tristanluther28/psx_dreamcast_radio/README.md

# PlayStation & Dreamcast Radio Controller!
More to come: Pardon our dust

https://tristanluther.com/projects/psx_dream_radio/
