tristanluther28/psx_dreamcast_radio/Enclosure/Lid.3mf

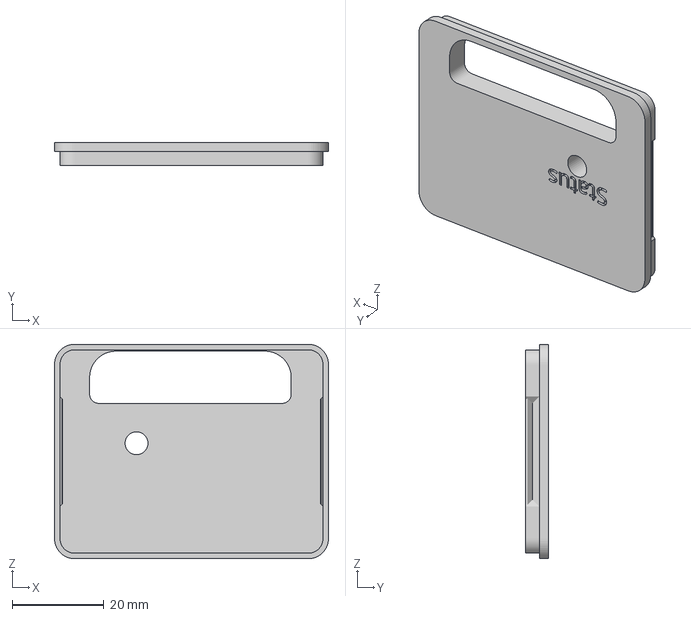
[picture p1: CAD file, 2021-08-06]
Enclosure/Lid.3mf
59.8 x 5.00 x 46.8 mm
