tristanluther28/psx_dreamcast_radio/Enclosure/Lower_Enclosure_PSX.3mf

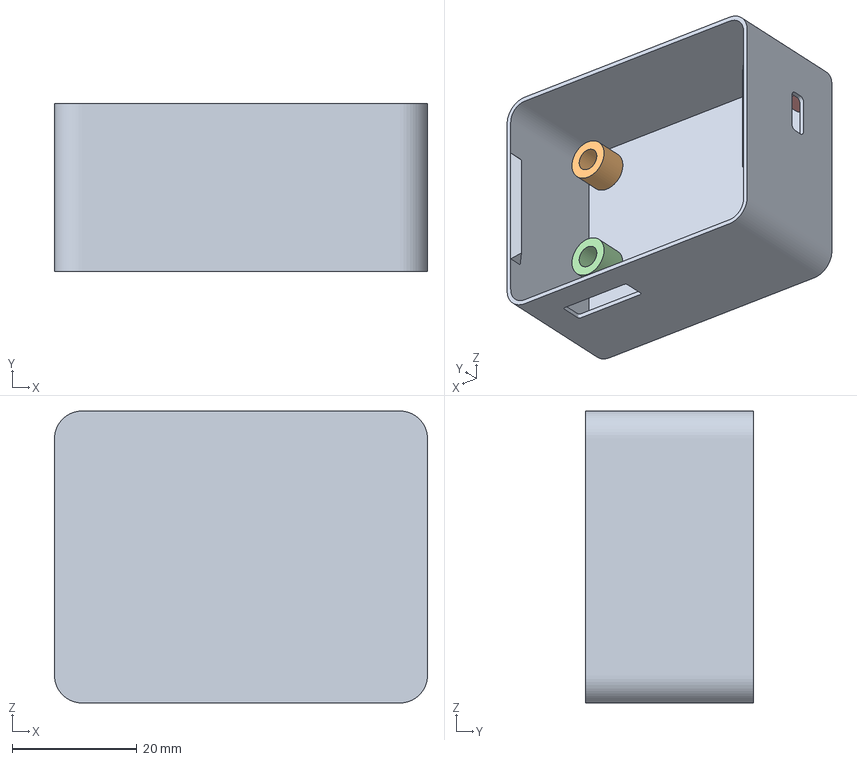
[picture p2: CAD file, 2021-08-06]
Enclosure/Lower_Enclosure_PSX.3mf
59.8 x 27.0 x 46.8 mm
