tristanluther28/psx_dreamcast_radio/(list of files, cad)

Other CAD files:
Enclosure/Lower_Enclosure_Dreamcast.3mf
