tristanluther28/psx_dreamcast_radio/PCB/PSX_Radio.brd

## EAGLE design PCB/PSX_Radio.brd (2021-08-06)

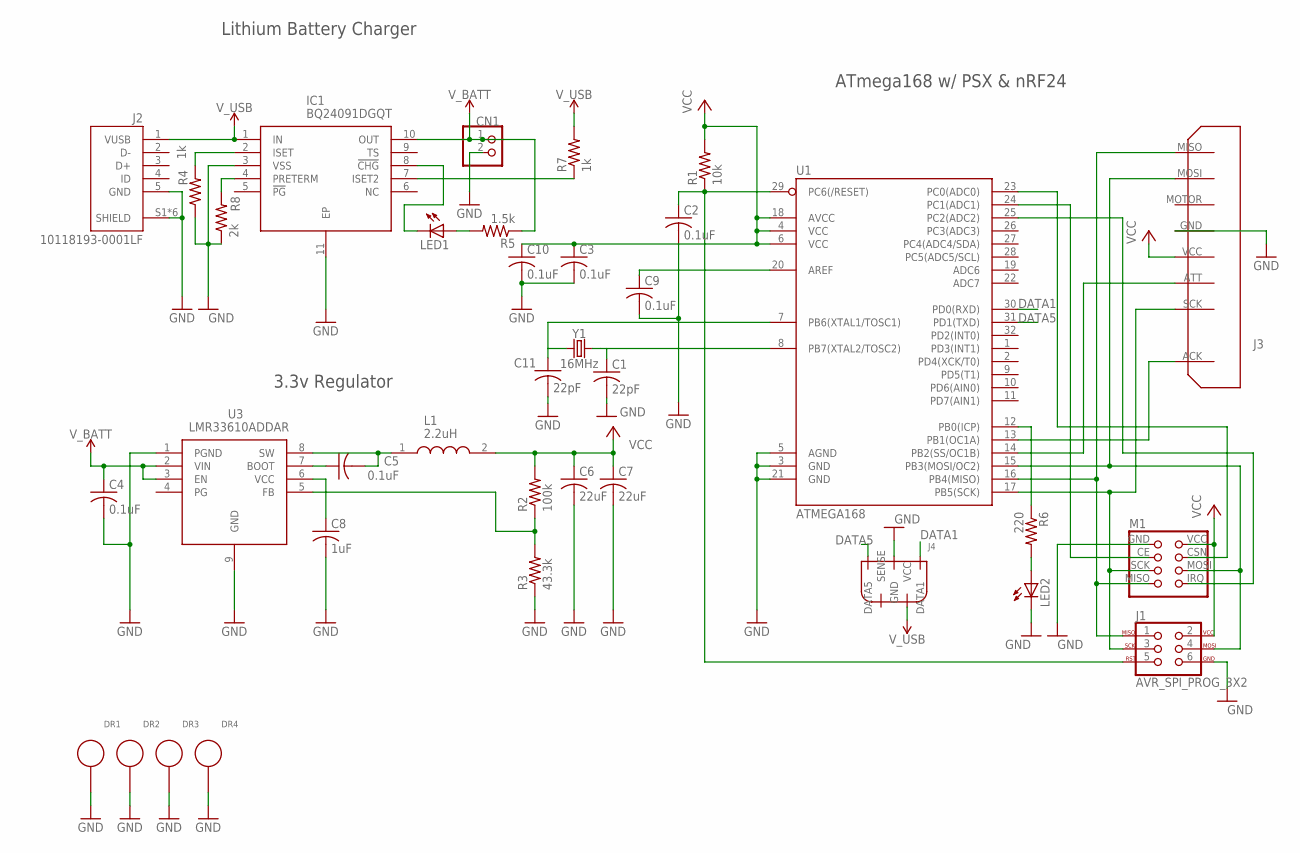
[picture p3: schematic PSX_Radio.sch]

Parts:
C1, C11: 22pF; C0805
C2, C3, C4, C5, C9, C10: 0.1uF; C0805
C6, C7: 22uF; C0805
C8: 1uF; C0805
CN1: JST_2PIN-SMT-RA; JST-PH-2-SMT-RA
DR1, DR2, DR3, DR4: 3MM_DRILL_GND
IC1: BQ24091DGQT; SOP50P490X110-11N
J1: AVR_SPI_PROG_3X2; 2X3-NS
J2: 10118193-0001LF; FCI_10118193-0001LF
J3: PSX_CONTROLLER; PSX_VERTICAL
J4: DREAMCAST_CONTROLLER; 1X06
L1: 2.2uH; INDPM5752X150N
LED1, LED2: LED5MM
M1: NRF24L01_MODULE; 2X04
R1: 10k; R0805
R2: 100k; R0805
R3: 43.3k; R0805
R4, R7: 1k; R0805
R5: 1.5k; R0805
R6: 220; R0805
R8: 2k; R0805
U1: ATMEGA168; TQFP32-08
U3: LMR33610ADDAR; SOIC127P600X170-9N
Y1: 16MHz; CRYSTAL-SMD-5X3.2-4PAD

Connections:
DATA1: J4.2 (DATA1), U1.30 (PD0(RXD))
DATA5: J4.4 (DATA5), U1.31 (PD1(TXD))
GND: C1.2, C2.2, C3.2, C4.2, C6.2, C7.2, C8.2, C9.2, C10.2, C11.2, CN1.2 (1), DR1.DR, DR2.DR, DR3.DR, DR4.DR, IC1.3 (VSS), IC1.11 (EP), J1.6, J2.5 (GND), J2.S1 (SHIELD), J2.S2 (SHIELD), J2.S3 (SHIELD), J2.S4 (SHIELD), J2.S5 (SHIELD), J2.S6 (SHIELD), J3.GND, J4.5 (GND), LED2.K (C), M1.GND, R3.1, R4.1, R8.1, U1.3 (GND), U1.5 (AGND), U1.21 (GND), U3.1 (PGND), U3.9 (GND)
unnamed: J1.1, J3.MISO, M1.MISO, U1.16 (PB4(MISO))
unnamed: J1.4, J3.MOSI, M1.MOSI, U1.15 (PB3(MOSI/OC2))
unnamed: J3.ACK, U1.13 (PB1(OC1A))
unnamed: M1.IRQ, U1.25 (PC2(ADC2))
unnamed: J1.3, J3.SCK, M1.SCK, U1.17 (PB5(SCK))
unnamed: M1.CE, U1.24 (PC1(ADC1))
unnamed: J3.ATT, U1.14 (PB2(SS/OC1B))
unnamed: M1.CSN, U1.23 (PC0(ADC0))
unnamed: C2.1, J1.5, R1.1, U1.29 (PC6(/RESET))
unnamed: C9.1, U1.20 (AREF)
unnamed: C5.1, U3.7 (BOOT)
unnamed: C5.2, L1.1, U3.8 (SW)
unnamed: IC1.2 (ISET), R4.2
unnamed: R2.1, R3.2, U3.5 (FB)
unnamed: C8.1, U3.6 (VCC)
unnamed: R6.1, U1.12 (PB0(ICP))
unnamed: LED2.A, R6.2
unnamed: C1.1, U1.8 (PB7(XTAL2/TOSC2)), Y1.3 (2)
unnamed: C11.1, U1.7 (PB6(XTAL1/TOSC1)), Y1.1
unnamed: LED1.A, R5.2
unnamed: IC1.8 (!CHG), LED1.K (C)
unnamed: IC1.7 (ISET2), R7.1
unnamed: IC1.4 (PRETERM), R8.2
VCC: C3.1, C6.1, C7.1, C10.1, J1.2, J3.VCC, L1.2, M1.VCC, R1.2, R2.2, U1.4 (VCC), U1.6 (VCC), U1.18 (AVCC)
V_BATT: C4.1, CN1.1 (2), IC1.10 (OUT), R5.1, U3.2 (VIN), U3.3 (EN)
V_USB: IC1.1 (IN), J2.1 (VUSB), J4.1 (VCC), R7.2

Notes on the sheet:
Lithium Battery Charger
3.3v Regulator
ATmega168 w/ PSX & nRF24

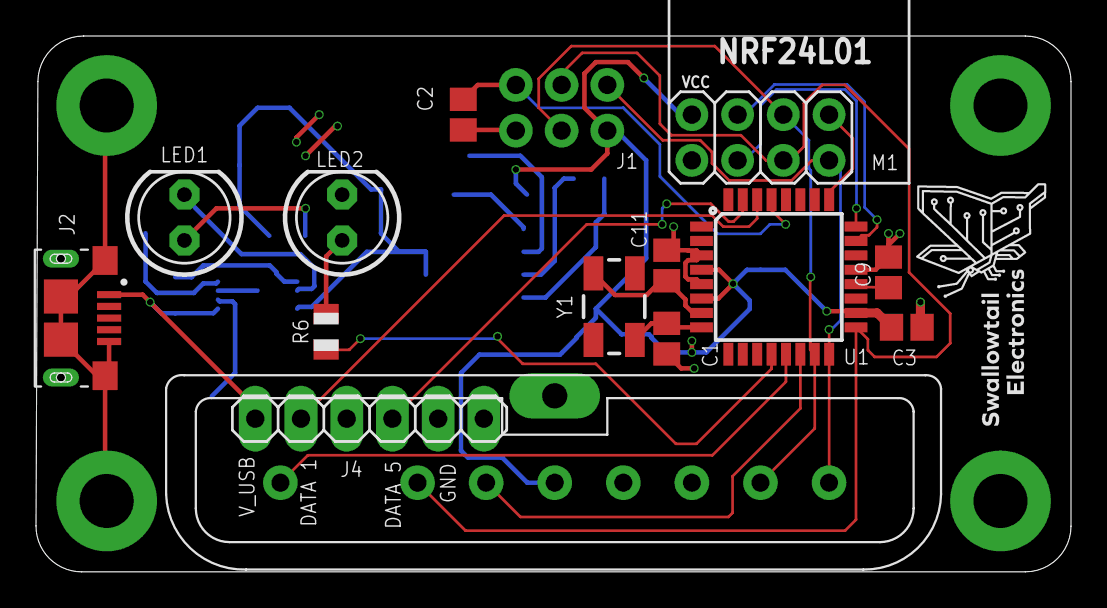
[picture p4: board PSX_Radio.brd from above]

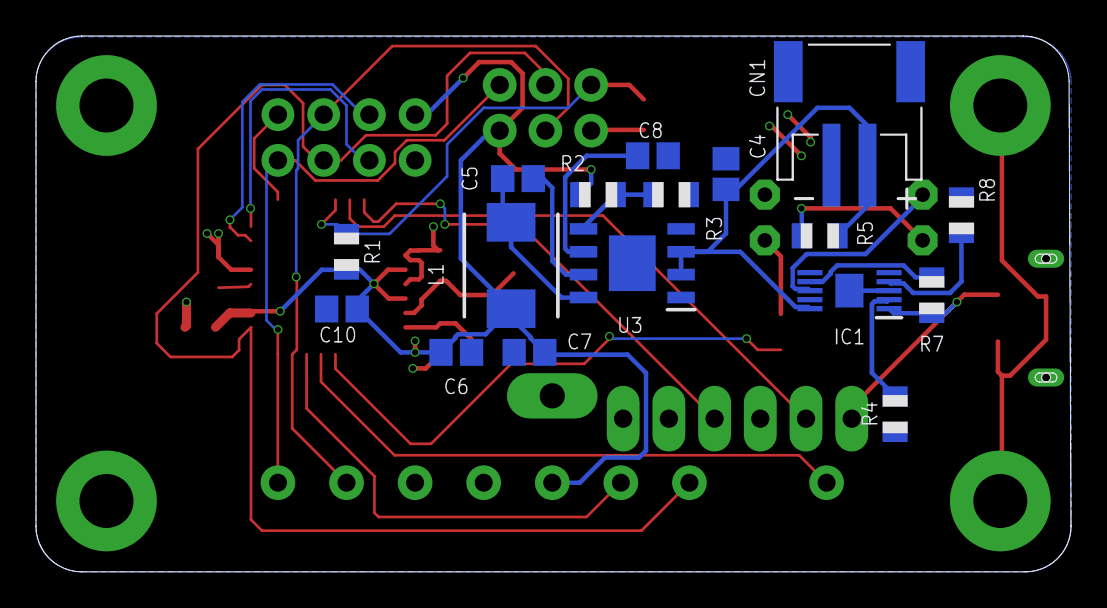
[picture p5: board PSX_Radio.brd from below]

Board: 2 copper layers, 57.5 x 29.8 mm, 37 parts (17 on the bottom side), 29 nets.

Other parts of the board:
U$3: SWALLOWTAIL_LOGO_SMALL
