tristanluther28/psx_dreamcast_radio/Dreamcast2.4GHz/AnimatorDreamcast2.4GHz/main.c

//-----------------------------------------------------------------------------
//
//  main.c
//
//  Swallowtail Animator Controller 2.4GHz Firmware
//  AVR (ATmega328P) Animator Controller 2.4GHz Firmware
//
//  Copyright (c) 2021 Swallowtail Electronics
//
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
//  Web:    http://tristanluther.com
//  Email:  tristanluther28@gmail.com
//
//-----------------------------------------------------------------------------

/******************** Macros *****************************/
#ifndef F_CPU
#define F_CPU 16000000UL //Set clock speed to 16MHz (External 16MHz @ 3.3V is overclocking the AVR according to the datasheet, should be fine)
#endif

#define BIT_SET(byte, bit) (byte & (1<<bit))

/******************** Includes ***************************/
#include <avr/io.h>
#include <avr/interrupt.h>
#include <avr/pgmspace.h>
#include <util/delay.h>

/******************* Globals *****************************/

//Must use the static keyword or the compiler will welcome itself to overwrite these memory locations in SRAM
//Must use volatile keyword or the compiler will optimize out any variables that are not seen in main (only appear in ISR)


/******************* Local Includes **********************/
#include "Dreamcast.h"
#include "nRF24L01.h"

/******************** Functions **************************/


/********** Interrupt Service Routines *******************/


/******************** Main *******************************/
int main(void)
{
	//nRF RX Address (5 bytes wide)
	static uint8_t rx_address[5] = {0x12, 0x12, 0x12, 0x12, 0x12};
	//nRF TX Address (5 bytes wide)
	static uint8_t tx_address[5] = {0x12, 0x12, 0x12, 0x12, 0x12};
	
	//Buffer for transmitting data
	static uint8_t tx_buffer[5];
	
	//Initialize the debug output
	DDRB |= (1<<PB0);
	//Set the default values for outputs to zero and inputs to have pull-up resistors
	PORTB |= (0<<PB0);
	
	//Get the current controller status
	static ControllerStatus controller;
	
	//Initialize the Dreamcast Communications
	Dreamcast_init();
	//Initialize the nRF24L01 Communications as a transmitter
	nRF24L01_init(TX, rx_address, tx_address);
	
	//Set interrupts
	sei();
	
	/* State machine loop */
	while (1)
	{
		//Get the current button status
		uint8_t success = Dreamcast_Read(&controller);
		//If that read was successful
		if(success){
			//If that read was successful
			//If the A button is non-zero
			if(BIT_SET(controller.buttons, DC_A)){
				PORTB |= (1<<PB0);
			}
			else if(BIT_SET(controller.buttons, DC_B)){
				PORTB &= ~(1<<PB0);
			}
			
			//Put controller data into the tx_buffer to be transmitted
			tx_buffer[0] = ((uint16_t)controller.buttons >> 0) & 0xFF; //First byte of digital buttons
			tx_buffer[1] = controller.ltrigger; //Left Analog Trigger
			tx_buffer[2] = controller.rtrigger; //Right Analog Trigger
			tx_buffer[3] = controller.joyx; //Left joystick for direction (X-coord)
			tx_buffer[4] = controller.joyy; //Left joystick for direction (Y-coord)
		
			//Transmit the controller data
			nRF24L01_Transmit(tx_buffer);
		
			//TODO improve buffer overflow issue
			//Check that the transmission was successful (If MAX_RT is 1 then the transmission failed)
			if((nRF24L01_ReadRegister(STATUS) & (1<<MAX_RT)) != 0){
				PORTB |= (1<<PB0);
				//Reset the nRF
				nRF24L01_Reset();
				PORTB &= ~(1<<PB0);
			}
			_delay_ms(10); //Might really mess up the MapleBus timing
		}
	}
}
