tristanluther28/psx_dreamcast_radio/(notices)

Notices in the files:
Dreamcast2.4GHz/AnimatorDreamcast2.4GHz/MapleBus.h:
This program is free software; you can redistribute it and/or modify
it under the terms of the GNU General Public License as published by
the Free Software Foundation; either version 2 of the License, or
(at your option) any later version.
parts and their libraries:
SparkFun-PowerSymbols: Licensing: Creative Commons ShareAlike 4.0 International - https://creativecommons.org/licenses/by-sa/4.0
